Zeroya/multifunctional-clock-with-detonation-mode/signet/Detonator clock.pdf

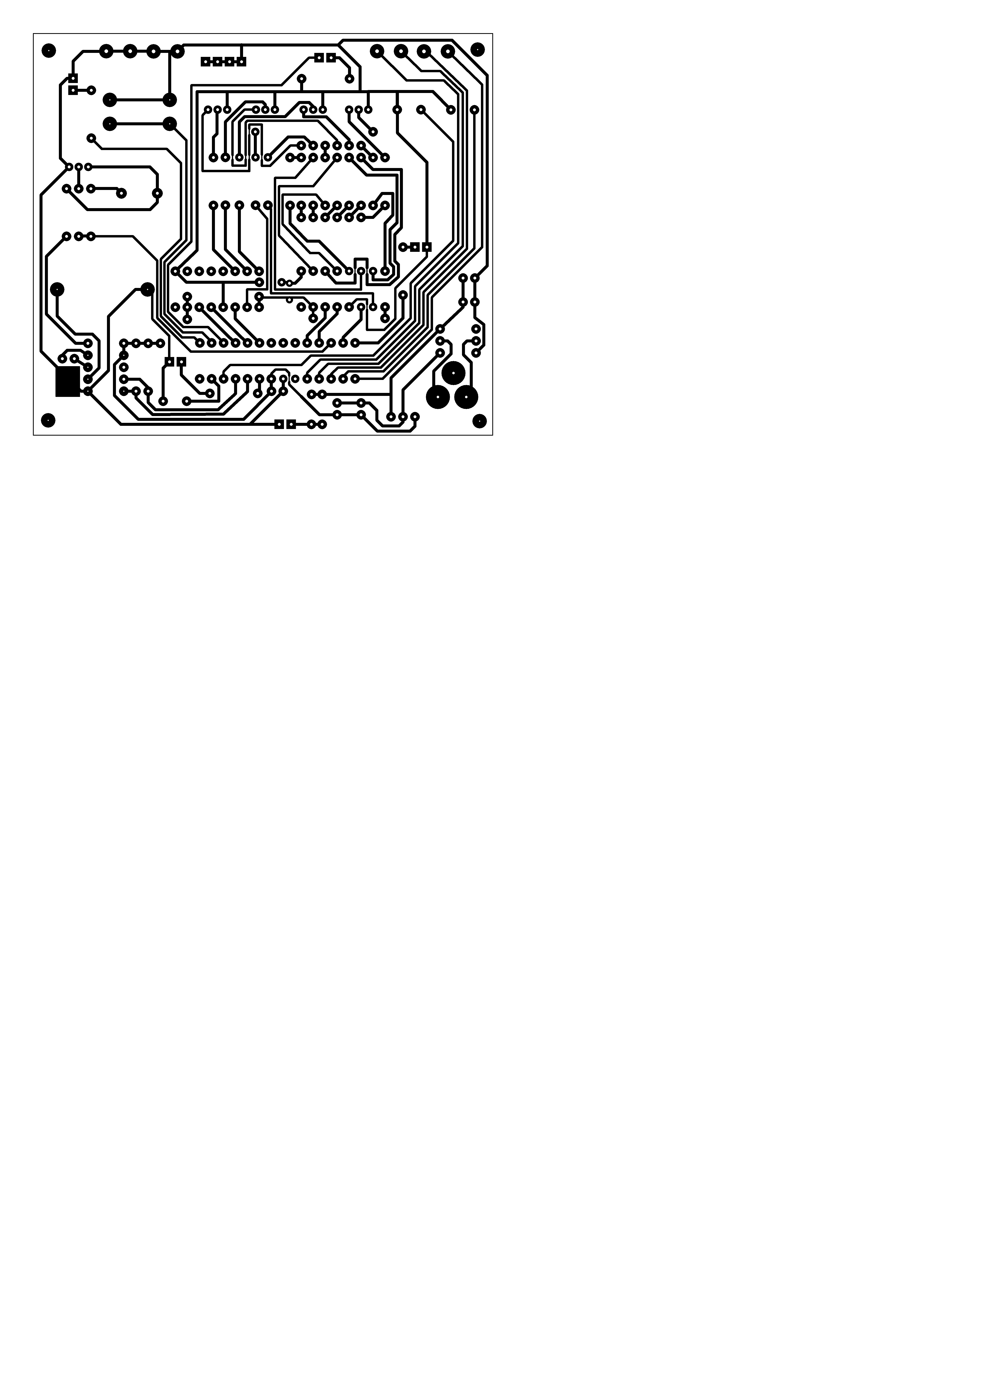
[picture p28: page 1]
