Zeroya/multifunctional-clock-with-detonation-mode/circuit_board.pdf

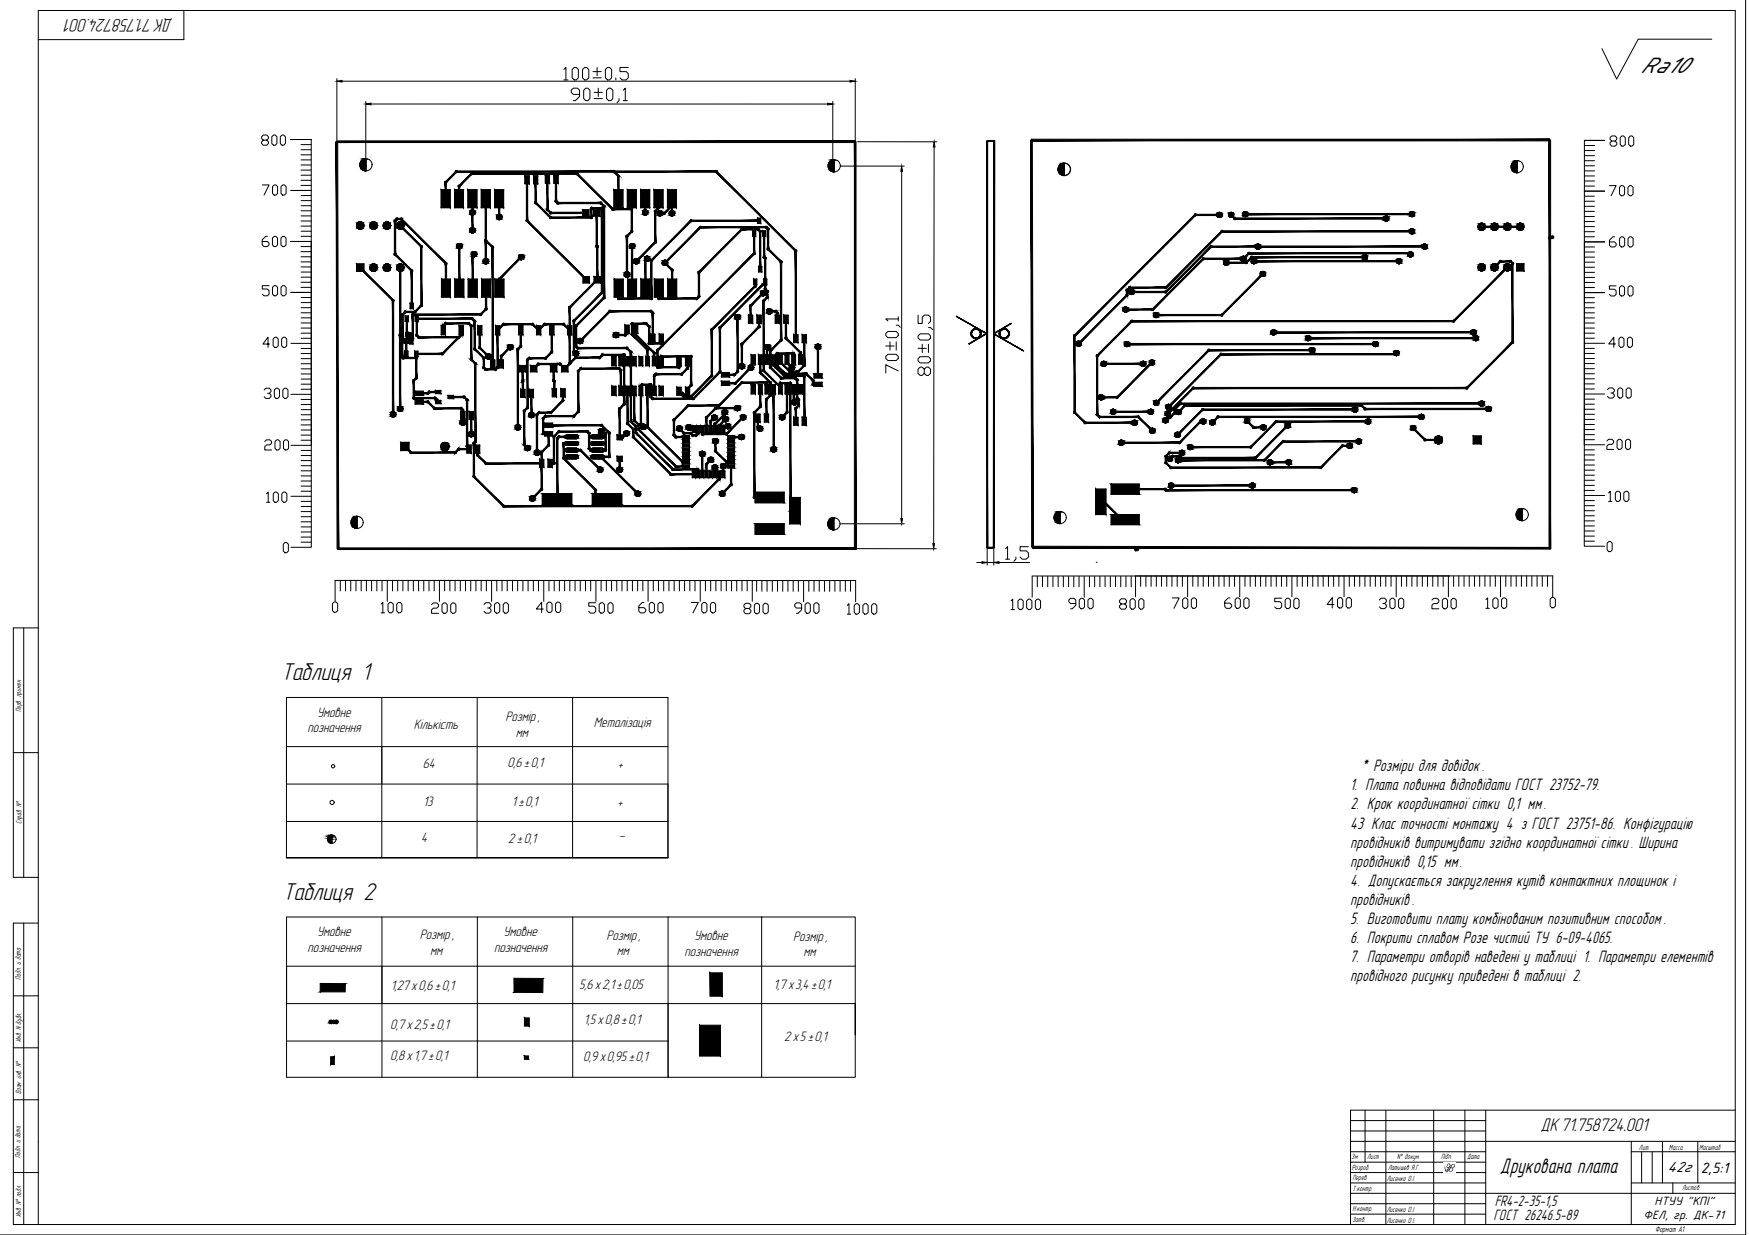
[picture p29: page 1]
Формат А1; Таблиця 1; Таблиця 2

Инв. N° подл. Перв. примен. Подп. и дата Взам. инв. N° Подп. и дата Инв. N дубл. Справ. N°

Умовне позначення | Кількість | Розмір, мм | Металізація

* Розміри для довідок . 1. Плата повинна відповідати ГОСТ 23752-79.

2. Крок координатної сітки 0,1 мм . 43 Клас точності монтажу 4 з ГОСТ 23751-86. Конфігурацію

провідників витримувати згідно координатної сітки . Ширина
провідників 0,15 мм . 4. Допускається закруглення кутів контактних площинок і

провідників . 5. Виготовити плату комбінованим позитивним способом . 6. Покрити сплавом Розе чистий ТУ 6-09-4065.

Умовне позначення | Розмір, мм | Умовне позначення | Розмір, мм | Умовне позначення | Розмір, мм

7. Параметри отворів наведені у таблиці 1. Параметри елементів
провідного рисунку приведені в таблиці 2.

Друкована плата | Лит. | Масса | Масштаб

Зм | Лист | N° докум. | Підп. | Дата | | | | | 42г | 2,5:1
Розроб. | | Латишев Я.Г.
Перев. | | Лисенко О.І.
Т.контр. | | | | | | Листов

FR4-2-35-1,5 ГОСТ 26246.5-89 | НТУУ "КПI" ФЕЛ, гр. ДК-71

Н.контр. | Лисенко О.І.
Затв. | Лисенко О.І.
