Zeroya/multifunctional-clock-with-detonation-mode/circuit_diagram.pdf

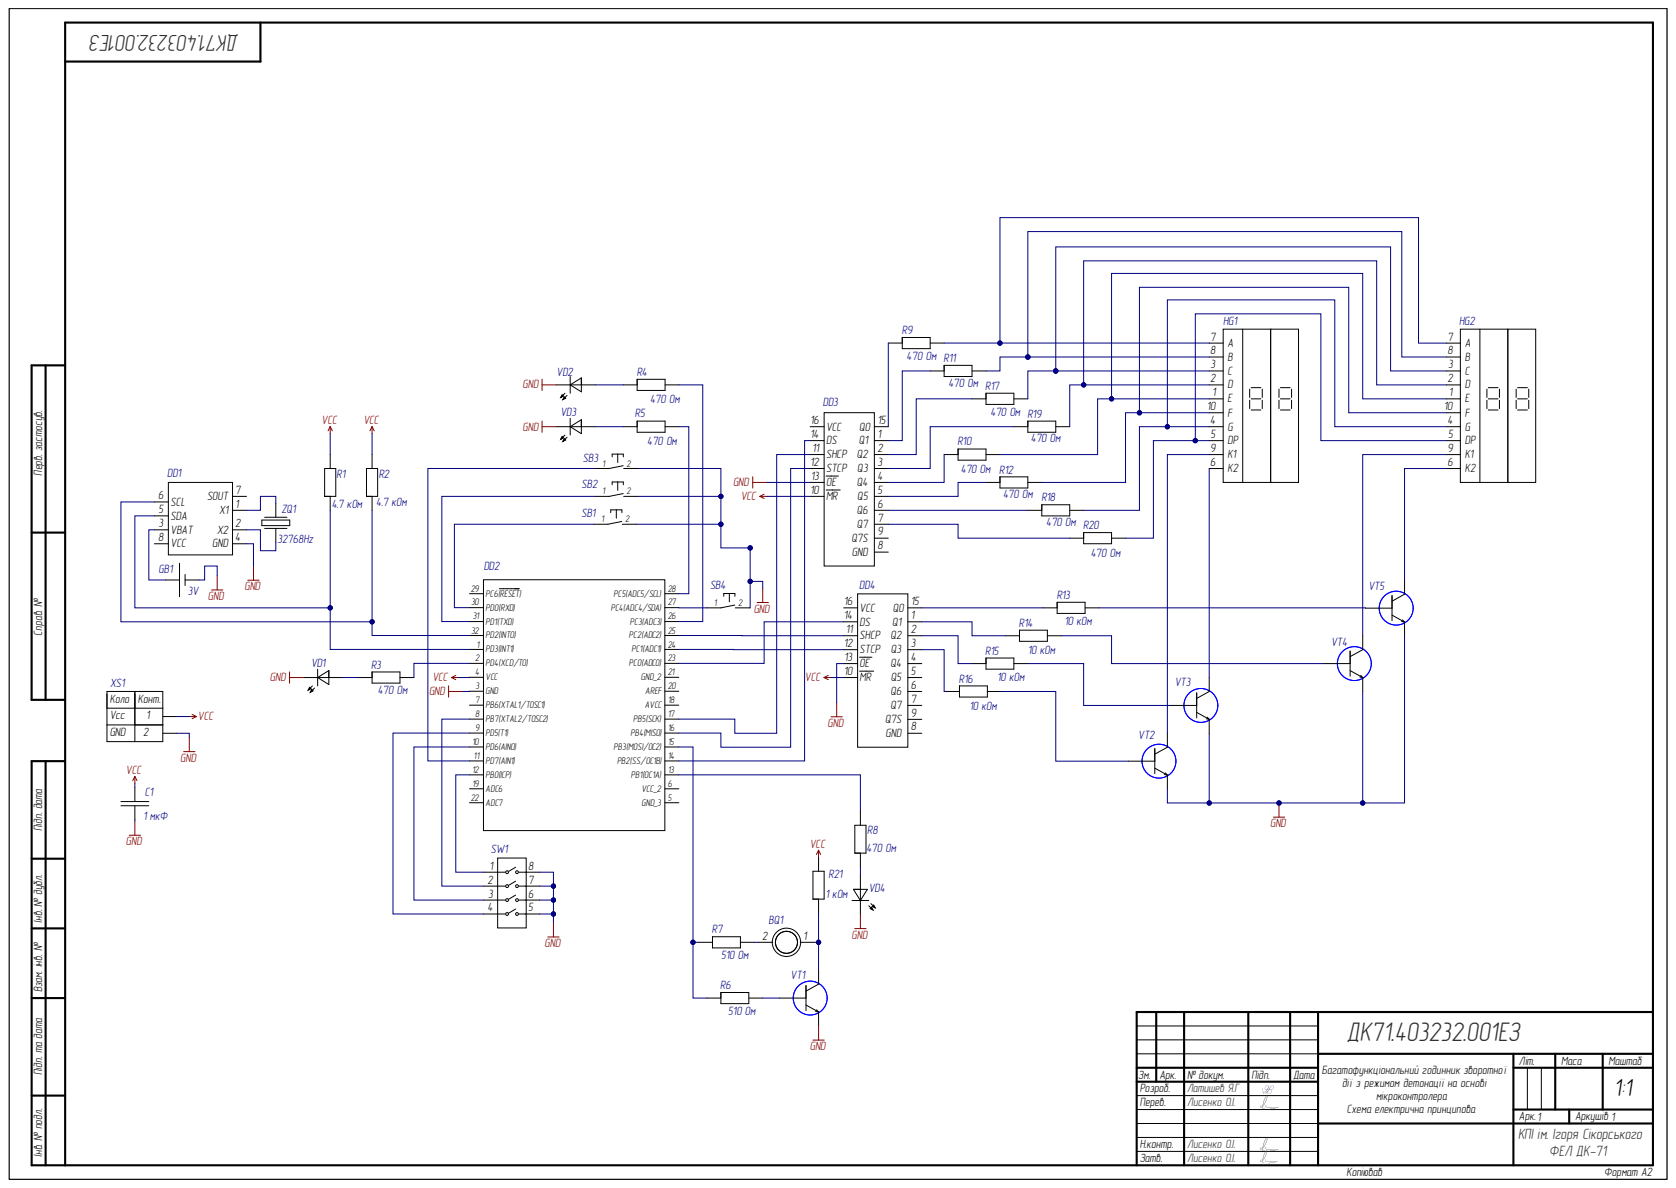
[picture p30: page 1]

Інв. № подл. Підп. та дата Взам. інв. № Інв. № дубл. Підп. дата Справ. № Перв. застосув.

X1 | 1 | ZQ1 | 4.7 кОм

PD2(INT0) 32 PD3(INT1) PD4(XCD/T0) VCC GND PB7(XTAL2/TOSC2) PD5(T1) | | SHCP 11 | 2
1 | | | STCP 12 | 3 | | R15
2 | | | MR 10 OE 13 | 4
4 | | | | 5 | | R16 | VT3

PD6(AIN0) 10

6 ADC6 19

Багатофункціональний годинник зворотної дії з режимом детонації на основі мікроконтролера Схема електрична принципова | Літ. | Маса | Маштаб

Зм. | Арк. | № докум. | Підп. | Дата | | | | | 1:1
Розроб. | | Латишев Я. Г
Перев. Н.контр | Арк. 1 | Аркушів 1

. | Лисенко О. І.
Затв. | Лисенко О. І.

КПІ ім. Ігоря Сікорського ФЕЛ ДК-71
