Zeroya/multifunctional-clock-with-detonation-mode/work_algorithm.pdf

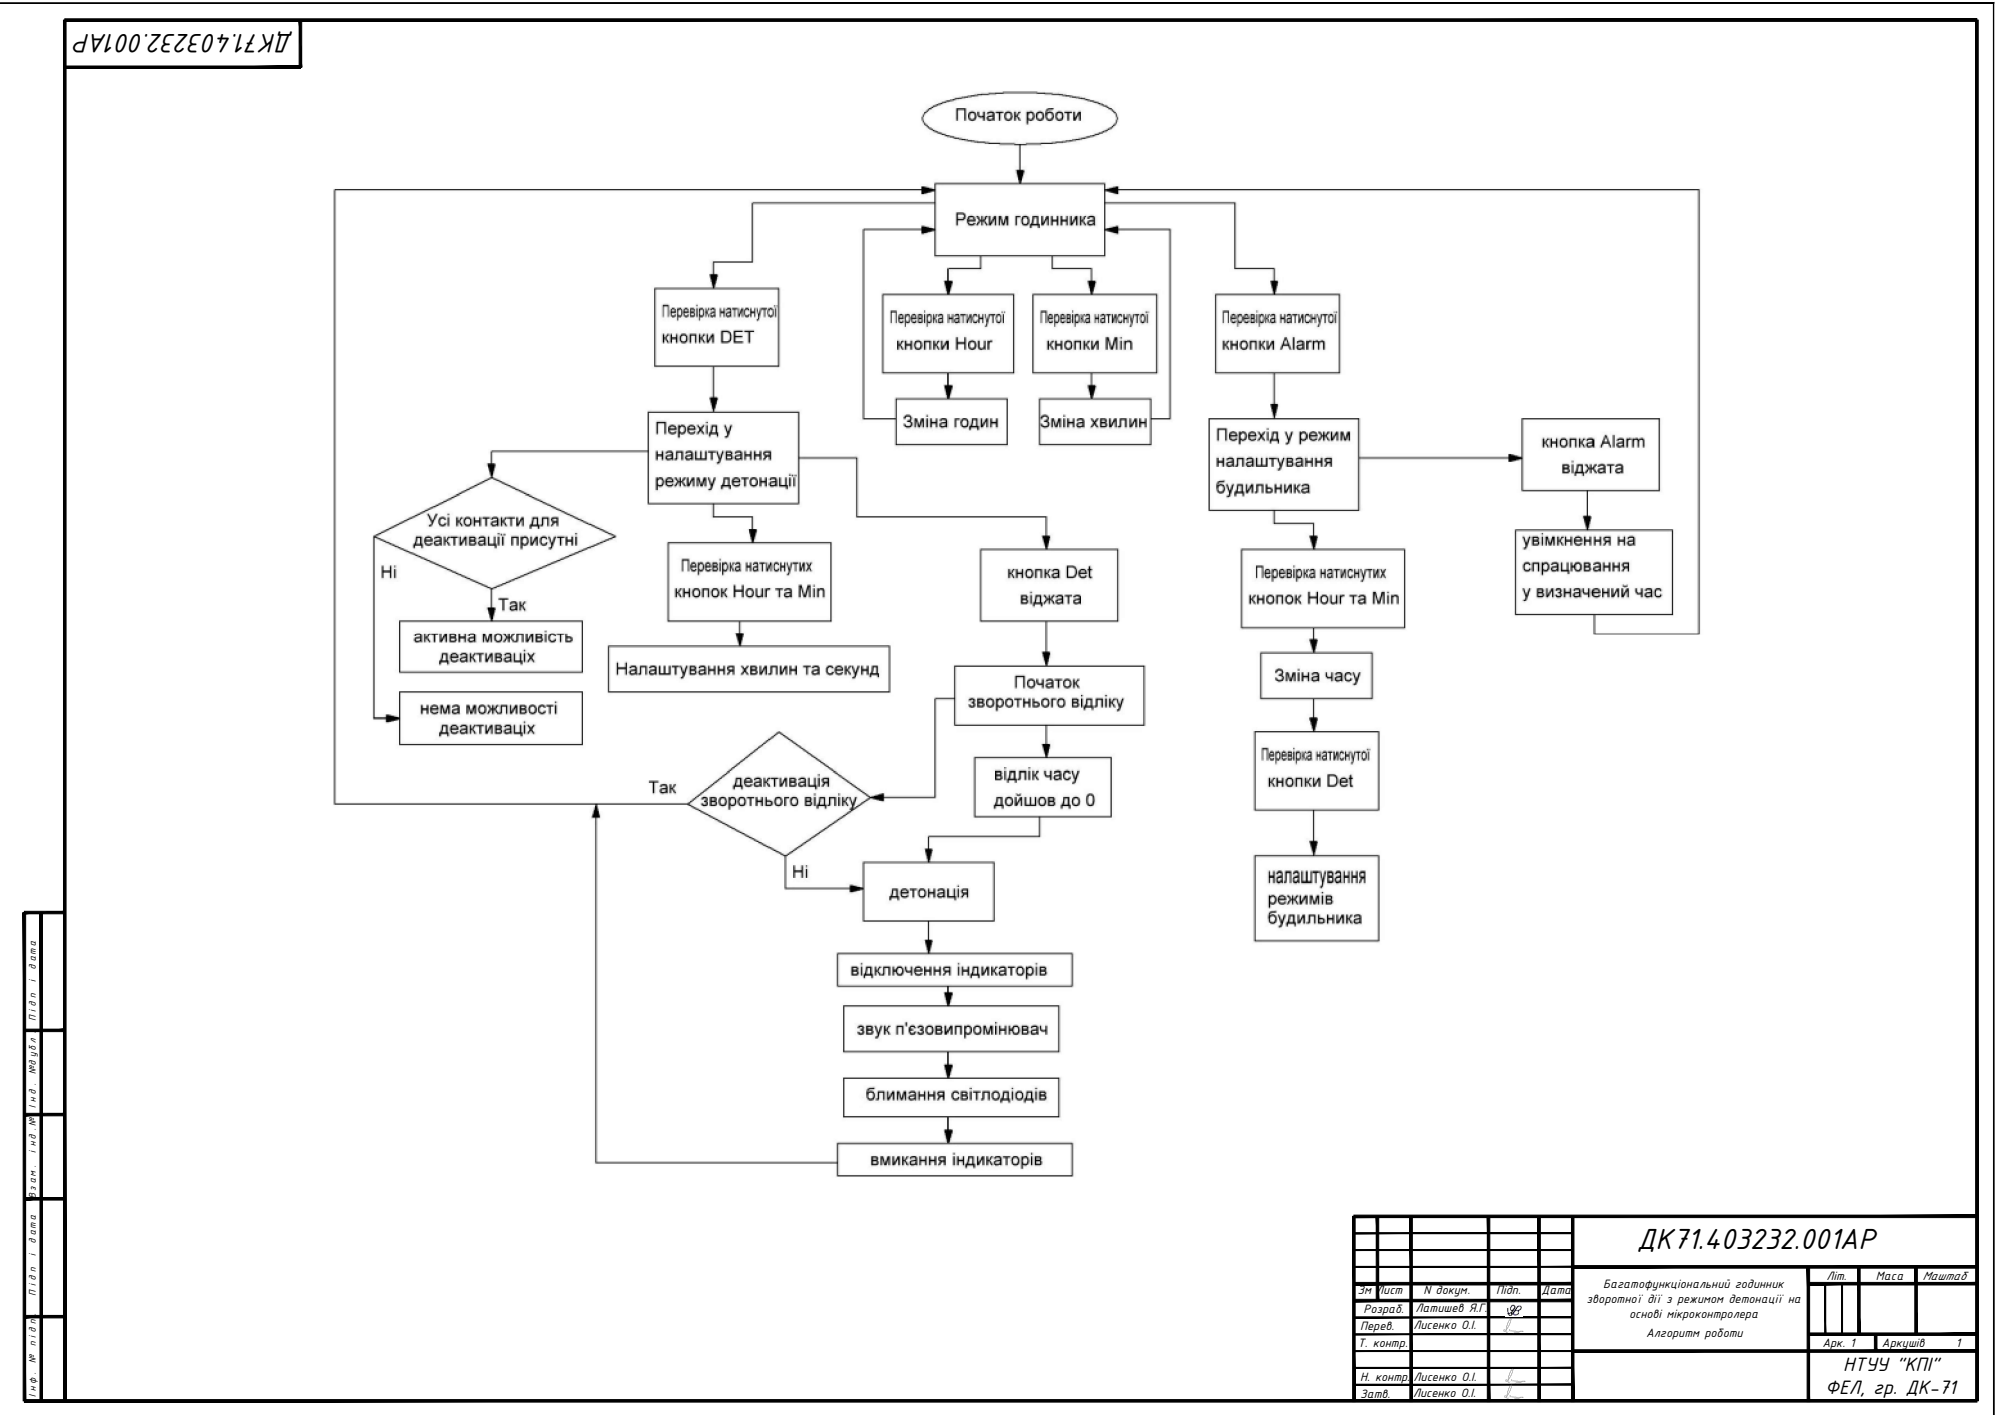
[picture p31: page 1]

ДК71.403232.001АР Інф. № підп. Підп і дата Взам. інд.№ Інд. №дубл. Підп і дата

Багатофункціональний годинник зворотної дії з режимом детонації на основі мікроконтролера Алгоритм роботи | Літ. Маcа Маштаб

Зм Лист | N докум. | Підп. | Дата
Розраб. | Латишев Я.Г.
Перев. | Лисенко О.І.
Т. контр. | | | | | Арк. 1 Аркушів 1

НТУУ "КПI" ФЕЛ, гр. ДК-71

Н. контр. | Лисенко О.І.
Затв. | Лисенко О.І.
