Zeroya/multifunctional-clock-with-detonation-mode/(list of files, drawings)

Other design files:
proteus_prim/clock.pdsprj
proteus_prim/first/clock1.pdsprj
proteus_prim/secondgrin/clock2.pdsprj
signet/Detonator clock.LYT
